algofoogle/tt08-vga-fun/xschem/simulation/segdac.spice

** sch_path: /home/anton/projects/tt08-vga-fun/xschem/segdac.sch
.subckt segdac sa1 vcc sa2 vss sa3 Vout sb1 sb2 Vbias sb3 sc1 sc2 sc3 sd1 sd2 sd3 bias1 bias2 bias3
*.PININFO vcc:B vss:B Vout:O Vbias:O sa1:I sa2:I sa3:I sb1:I sb2:I sb3:I sc1:I sc2:I sc3:I sd1:I sd2:I sd3:I bias1:I bias2:I
*+ bias3:I
XMmirror Vbias Vbias vss vss sky130_fd_pr__nfet_01v8 L=0.5 W=0.5 nf=1 m=1
XMia1 net1 Vbias vss vss sky130_fd_pr__nfet_01v8 L=5 W=0.5 nf=1 m=1
XMia2 net2 Vbias vss vss sky130_fd_pr__nfet_01v8 L=5 W=0.5 nf=1 m=1
XMia3 net3 Vbias vss vss sky130_fd_pr__nfet_01v8 L=5 W=0.5 nf=1 m=1
XMsa1 Vout sa1 net1 vss sky130_fd_pr__nfet_01v8 L=0.15 W=0.5 nf=1 m=1
XMsa2 Vout sa2 net2 vss sky130_fd_pr__nfet_01v8 L=0.15 W=0.5 nf=1 m=1
XMsa3 Vout sa3 net3 vss sky130_fd_pr__nfet_01v8 L=0.15 W=0.5 nf=1 m=1
XMib1 net4 Vbias vss vss sky130_fd_pr__nfet_01v8 L=1.2 W=0.5 nf=1 m=1
XMib2 net5 Vbias vss vss sky130_fd_pr__nfet_01v8 L=1.2 W=0.5 nf=1 m=1
XMib3 net6 Vbias vss vss sky130_fd_pr__nfet_01v8 L=1.2 W=0.5 nf=1 m=1
XMsb1 Vout sb1 net4 vss sky130_fd_pr__nfet_01v8 L=0.15 W=1 nf=1 m=1
XMsb2 Vout sb2 net5 vss sky130_fd_pr__nfet_01v8 L=0.15 W=1 nf=1 m=1
XMsb3 Vout sb3 net6 vss sky130_fd_pr__nfet_01v8 L=0.15 W=1 nf=1 m=1
XMic1 net7 Vbias vss vss sky130_fd_pr__nfet_01v8 L=0.5 W=1 nf=1 m=1
XMic2 net8 Vbias vss vss sky130_fd_pr__nfet_01v8 L=0.5 W=1 nf=1 m=1
XMic3 net9 Vbias vss vss sky130_fd_pr__nfet_01v8 L=0.5 W=1 nf=1 m=1
XMsc1 Vout sc1 net7 vss sky130_fd_pr__nfet_01v8 L=0.15 W=1.4 nf=1 m=1
XMsc2 Vout sc2 net8 vss sky130_fd_pr__nfet_01v8 L=0.15 W=1.4 nf=1 m=1
XMsc3 Vout sc3 net9 vss sky130_fd_pr__nfet_01v8 L=0.15 W=1.4 nf=1 m=1
XMid1 net10 Vbias vss vss sky130_fd_pr__nfet_01v8 L=0.3 W=2.6 nf=1 m=1
XMid2 net11 Vbias vss vss sky130_fd_pr__nfet_01v8 L=0.3 W=2.6 nf=1 m=1
XMid3 net12 Vbias vss vss sky130_fd_pr__nfet_01v8 L=0.3 W=2.6 nf=1 m=1
XMsd1 Vout sd1 net10 vss sky130_fd_pr__nfet_01v8 L=0.2 W=3.3 nf=1 m=1
XMsd2 Vout sd2 net11 vss sky130_fd_pr__nfet_01v8 L=0.2 W=3.3 nf=1 m=1
XMsd3 Vout sd3 net12 vss sky130_fd_pr__nfet_01v8 L=0.2 W=3.3 nf=1 m=1
XM1 Vbias bias1 vcc vcc sky130_fd_pr__pfet_01v8 L=0.5 W=0.5 nf=1 m=1
XM2 Vbias bias2 vcc vcc sky130_fd_pr__pfet_01v8 L=1 W=0.5 nf=1 m=1
XM3 Vbias bias3 vcc vcc sky130_fd_pr__pfet_01v8 L=2 W=0.5 nf=1 m=1
.ends
.end
