algofoogle/tt08-vga-fun/(commit log)

2024-08-09 Copy tt-vga-fun's '11-ratioed.sch' as: csdac.sch
    [csdac.sch]
2024-08-09 Clean up CSDAC and make TB
    [csdac.sch, tb_csdac.sch, tt08_analog_load.sch]
2024-08-09 Fix CSDAC pull-ups
    [csdac.sch]
2024-08-09 TT08 pin model (approx)
    [tb_csdac.sch, tt08pin.sch]
2024-08-11 Parametric CSDAC
    [csdac.sch, tb_csdac.sch]
2024-08-11 Add csdac_nom (parametric CSDAC nominal instance) for layout
    [csdac_nom.sch, tb_csdac.sch]
2024-08-11 Starting to add mag/ stuff (from tt06/tt07 at this point)
    [tb_csdac.sch, tt08_analog_load.sch]
2024-08-11 Change csdac_nom: Fixed-val csdac copy, not parametric
    [csdac.sch, csdac_nom.sch, tb_csdac.sch]
2024-08-11 Start 1st layout attempt; device instances in csdac_nom__devices/ subdir
2024-08-16 Comparing csdac_nom sims: schematic vs. layout
    [tb_csdac_nom.sch]
2024-08-18 Minor Vbias layout update. Makes little difference
    [tb_csdac_nom.sch]
2024-08-18 Add digital block source from tt-vga-fun
    [pin_order.cfg]
2024-08-19 Tweak for better DAC pin matching
    [pin_order.cfg]
2024-08-20 First top layout with digital controller and CSDAC. LVS clean.
    See: https://github.com/algofoogle/journal/blob/master/0214-2024-08-17.md
    [pin_order.cfg]
2024-08-23 CSDAC narrower, all 3 instances (RGB)
    [csdac_nom.sch]
2024-09-02 Extra pin load for full sim. Simulate bars mode instead
2024-09-04 Trying a segmented DAC
    [segdac.sch, tb_segdac.sch, thermo2bit.sch]
2024-09-05 Tweaking segdac
    [segdac.sch, tb_csdac_nom.sch, tb_segdac.sch, thermo2bit.sch]
2024-09-05 Stronger, better, positive segdac
    [segdac.sch, tb_segdac.sch]
2024-09-05 Segdac with digital Vbias adjustment
    [segdac.sch, tb_segdac.sch]
2024-09-06 Move segdac devices into subdir
2024-09-06 Layout for thermo2bit decoder
    [thermo2bit.sch]
2024-09-08 Improve sims inc. segdac PEX
    [tb_segdac_pex.sch]
